kingston-hackSpace/Rotary_Dial_Phone/wiring_notes.jpg

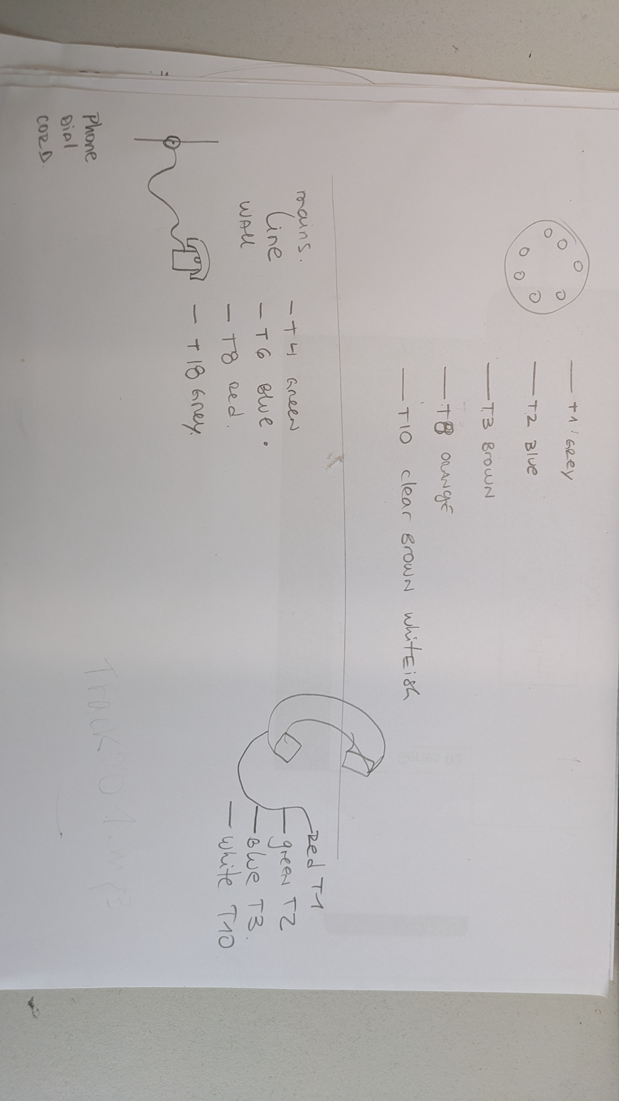
wiring_notes.jpg
