kingston-hackSpace/Rotary_Dial_Phone/Phone_parts.jpg

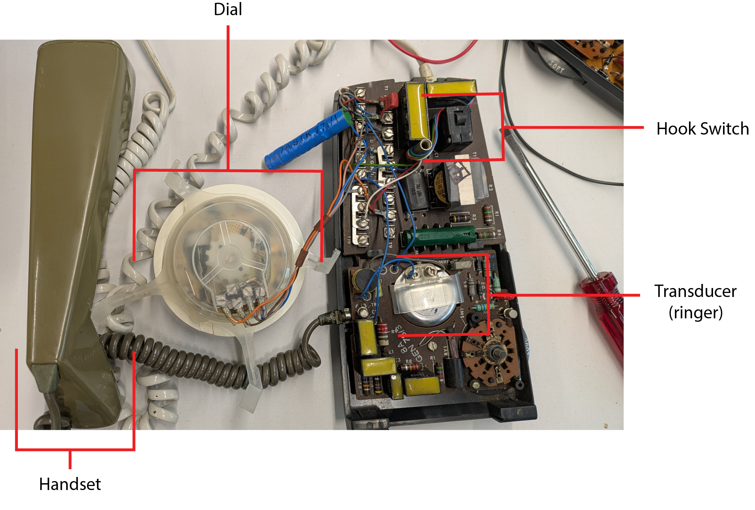
Phone_parts.jpg
