kingston-hackSpace/Rotary_Dial_Phone/README.md

# Rotary Dial Phone

[Programming the Trimphone](https://github.com/kingston-hackSpace/Rotary_Dial_Phone/blob/main/The_Trimphone.md)

[Simple Intercom From a Pair of Old Corded Phones](https://makezine.com/projects/simple-intercom-from-a-pair-of-old-corded-phones/)
