kingston-hackSpace/Rotary_Dial_Phone/test_hook-switch.jpg

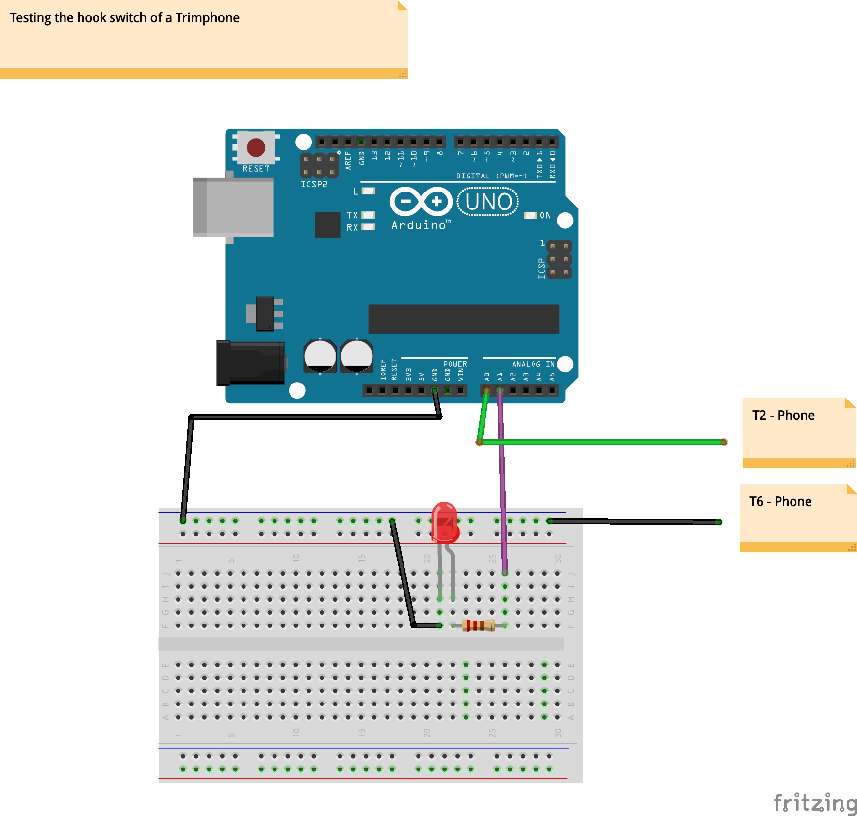
test_hook-switch.jpg
