kingston-hackSpace/Rotary_Dial_Phone/test_transducer_bb.jpg

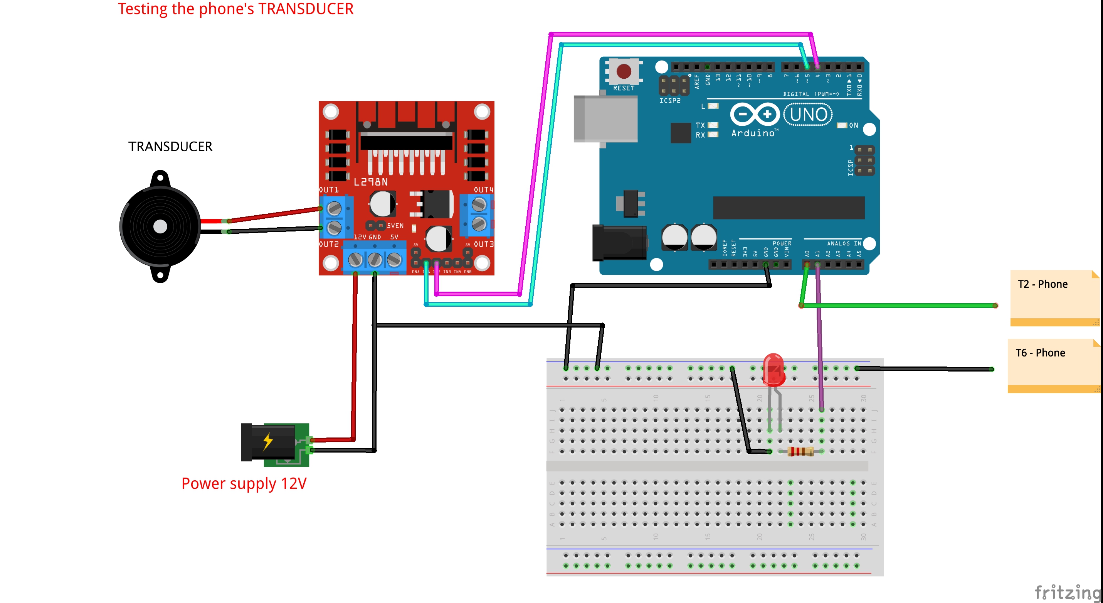
test_transducer_bb.jpg
